kttui/Smart-Range-Hood-Closed-Loop-Control-and-Online-Upgrade-System/(list of files, cad)

Other CAD files:
基于STM32+FreeRTOS的智能油烟机闭环控制与在线升级系统V1/Objects/test_server_signature.obj
基于STM32+FreeRTOS的智能油烟机闭环控制与在线升级系统V1/Objects/boot_p256.obj
基于STM32+FreeRTOS的智能油烟机闭环控制与在线升级系统V1/Objects/test_p256.obj
