kttui/Smart-Range-Hood-Closed-Loop-Control-and-Online-Upgrade-System/基于STM32+FreeRTOS的智能油烟机闭环控制与在线升级系统V1/Application/control_task.c

#include "control_task.h"
#include "control_service.h"
#include "message_def.h"
#include "FreeRTOS.h"
#include "queue.h"

void control_task(void *pvParameters)
{
    SystemEvent_t event;

    (void)pvParameters;

    Control_Service_Init();

    while (1)
    {
        if (xQueueReceive(system_event_queue, &event, portMAX_DELAY) == pdTRUE)
        {
            Control_Service_ProcessEvent(&event);
        }
    }
}
