kttui/Smart-Range-Hood-Closed-Loop-Control-and-Online-Upgrade-System/基于STM32+FreeRTOS的智能油烟机闭环控制与在线升级系统V1/Driver/drv_encoder.h

#ifndef __DRV_ENCODER_H
#define __DRV_ENCODER_H

#include <stdint.h>

void Encoder_Init(void);
int16_t Encoder_GetDeltaAndReset(void);
int16_t Encoder_CalcRpm(int16_t delta_count, uint16_t sample_ms);

#endif
