kttui/Smart-Range-Hood-Closed-Loop-Control-and-Online-Upgrade-System/基于STM32+FreeRTOS的智能油烟机闭环控制与在线升级系统V1/Service/motor_control_service.h

#ifndef __MOTOR_CONTROL_SERVICE_H
#define __MOTOR_CONTROL_SERVICE_H

#include "stm32f10x.h"

#define MOTOR_CONTROL_SERVICE_PERIOD_MS      50

void Motor_Control_Service_Init(void);
void Motor_Control_Service_Process(void);

#endif /* __MOTOR_CONTROL_SERVICE_H */
