kttui/Smart-Range-Hood-Closed-Loop-Control-and-Online-Upgrade-System/基于STM32+FreeRTOS的智能油烟机闭环控制与在线升级系统V1/BSP/bsp_delay.c

#include "bsp_delay.h"
#include "bsp_sys.h"
////////////////////////////////////////////////////////////////////////////////// 	 
//如果需要使用OS,则包括下面的头文件即可.
#if SYSTEM_SUPPORT_OS
#include "FreeRTOS.h"					//FreeRTOS使用		  
#include "task.h" 
//extern led_d led1; /*used to debug*/
#endif
//////////////////////////////////////////////////////////////////////////////////	 
//本程序只供学习使用，未经作者许可，不得用于其它任何用途
//ALIENTEK STM32开发板
//使用SysTick的普通计数模式对延迟进行管理(支持OS)
//包括delay_us,delay_ms
//正点原子@ALIENTEK
//技术论坛:www.openedv.com
//创建日期:2016/11/28
//版本：V1.8
//版权所有，盗版必究。
//Copyright(C) 广州市星翼电子科技有限公司 2009-2019
//All rights reserved
//********************************************************************************
//修改说明
//////////////////////////////////////////////////////////////////////////////////  

static u8  fac_us=0;							//us延时倍乘数			   
static u16 fac_ms=0;							//ms延时倍乘数,在ucos下,代表每个节拍的ms数
 
 extern void xPortSysTickHandler(void);//OS的心跳函数声明--不甘心的咸鱼注

//systick中断服务函数,使用os时用到
void SysTick_Handler(void)
{	
    if(xTaskGetSchedulerState()!=taskSCHEDULER_NOT_STARTED)//系统已经运行
    {
		//led_off(&led1);//used to debug
        xPortSysTickHandler();	
    }
}

			   
//初始化延迟函数
//SYSTICK的时钟固定为AHB时钟，基础例程里面SYSTICK时钟频率为AHB/8
//这里为了兼容FreeRTOS，所以将SYSTICK的时钟频率改为AHB的频率！
//SYSCLK:系统时钟频率
void delay_init()
{
	uint32_t  reload;
	SysTick_CLKSourceConfig(SysTick_CLKSource_HCLK);//选择外部时钟  HCLK
	fac_us=SystemCoreClock/1000000;				//不论是否使用OS,fac_us都需要使用
	reload=SystemCoreClock/1000000;				//每秒钟的计数次数 单位为M  
	reload*=1000000/configTICK_RATE_HZ;			//根据configTICK_RATE_HZ设定溢出时间
												//reload为24位寄存器,最大值:16777216,在72M下,约合0.233s左右	
	fac_ms=1000/configTICK_RATE_HZ;				//代表OS可以延时的最少单位	   

	SysTick->CTRL|=SysTick_CTRL_TICKINT_Msk;   	//开启SYSTICK中断
	SysTick->LOAD=reload; 						//每1/configTICK_RATE_HZ秒中断一次	
	SysTick->CTRL|=SysTick_CTRL_ENABLE_Msk;   	//开启SYSTICK    
}								    


//延时nus
//nus:要延时的us数.	
//nus:0~204522252(最大值即2^32/fac_us@fac_us=168)	    								   
void delay_us(u32 nus)
{		
	u32 ticks;
	u32 told,tnow,tcnt=0;
	u32 reload=SysTick->LOAD;				//LOAD的值	    	 
	ticks=nus*fac_us; 						//需要的节拍数 
	told=SysTick->VAL;        				//刚进入时的计数器值
	while(1)
	{
		tnow=SysTick->VAL;	
		if(tnow!=told)
		{	    
			if(tnow<told)tcnt+=told-tnow;	//这里注意一下SYSTICK是一个递减的计数器就可以了.
			else tcnt+=reload-tnow+told;	    
			told=tnow;
			if(tcnt>=ticks)break;			//时间超过/等于要延迟的时间,则退出.
		}  
	};										    
}  
//延时nms
//nms:要延时的ms数
//nms:0~65535
void delay_ms(u32 nms)
{	
	if(xTaskGetSchedulerState()!=taskSCHEDULER_NOT_STARTED)//系统已经运行
	{		
		if(nms>=fac_ms)						//延时的时间大于OS的最少时间周期 
		{ 
   			vTaskDelay(nms/fac_ms);	 		//FreeRTOS延时
		}
		nms%=fac_ms;						//OS已经无法提供这么小的延时了,采用普通方式延时    
	}
	delay_us((u32)(nms*1000));				//普通方式延时
}

//延时nms,不会引起任务调度
//nms:要延时的ms数
void delay_xms(u32 nms)
{
	u32 i;
	for(i=0;i<nms;i++) delay_us(1000);
}
