kttui/Smart-Range-Hood-Closed-Loop-Control-and-Online-Upgrade-System/基于STM32+FreeRTOS的智能油烟机闭环控制与在线升级系统V1/Driver/drv_key.h

#ifndef __DRV_KEY_H
#define __DRV_KEY_H

#include <stdint.h>

typedef enum
{
    KEY_ID_NONE = 0,
    KEY_ID_MODE,
    KEY_ID_SPEED,
    KEY_ID_LIGHT,
    KEY_ID_UPGRADE
} KeyId_t;

typedef enum
{
    KEY_ACTION_NONE = 0,
    KEY_ACTION_SHORT,
    KEY_ACTION_LONG
} KeyAction_t;

typedef struct
{
    KeyId_t id;
    KeyAction_t action;
} KeyEvent_t;

void Key_Init(void);
uint8_t Key_Scan(KeyEvent_t *event);

#endif
