kttui/Smart-Range-Hood-Closed-Loop-Control-and-Online-Upgrade-System/基于STM32+FreeRTOS的智能油烟机闭环控制与在线升级系统V1/Service/anti_backflow_service.h

#ifndef __ANTI_BACKFLOW_SERVICE_H
#define __ANTI_BACKFLOW_SERVICE_H

#include "stm32f10x.h"

#define ANTI_BACKFLOW_SERVICE_PERIOD_MS      100

typedef enum
{
    BACKFLOW_IDLE = 0,
    BACKFLOW_MONITORING,
    BACKFLOW_ACTIVE,
    BACKFLOW_RECOVERY
} BackflowState_t;

void Anti_Backflow_Service_Init(void);
void Anti_Backflow_Service_Process(void);

#endif /* __ANTI_BACKFLOW_SERVICE_H */
