kttui/Smart-Range-Hood-Closed-Loop-Control-and-Online-Upgrade-System/基于STM32+FreeRTOS的智能油烟机闭环控制与在线升级系统V1/Service/speed_service.h

#ifndef __SPEED_SERVICE_H
#define __SPEED_SERVICE_H

#include "stm32f10x.h"

#define SPEED_SERVICE_PERIOD_MS      50

void Speed_Service_Init(void);
void Speed_Service_Process(void);

#endif /* __SPEED_SERVICE_H */
