kttui/Smart-Range-Hood-Closed-Loop-Control-and-Online-Upgrade-System/基于STM32+FreeRTOS的智能油烟机闭环控制与在线升级系统V1/Bootloader/boot_flash.h

#ifndef __BOOT_FLASH_H
#define __BOOT_FLASH_H

#include <stdint.h>

int BootFlash_EraseApplication(void);
int BootFlash_Write(uint32_t offset, const uint8_t *data, uint16_t length);
int BootFlash_Matches(uint32_t offset, const uint8_t *data, uint16_t length);
int BootFlash_VectorIsValid(void);

#endif /* __BOOT_FLASH_H */
