kttui/Smart-Range-Hood-Closed-Loop-Control-and-Online-Upgrade-System/基于STM32+FreeRTOS的智能油烟机闭环控制与在线升级系统V1/Bootloader/test_p256.c

#include "boot_p256.h"
#include <stdio.h>

static const unsigned char public_key[64] = {
    0x46,0x28,0xca,0xb0,0x78,0xf2,0x2d,0x11,0x56,0xed,0xe9,0x50,0xf4,0xf5,0x0d,0xb0,
    0xbe,0x49,0xd2,0x25,0xd3,0x68,0xcd,0xf5,0xaf,0x61,0x94,0x73,0x71,0x9d,0xe7,0xa3,
    0x47,0x9e,0x4d,0xaa,0x9f,0x87,0x3a,0xa7,0x7c,0x84,0xe3,0x90,0x5e,0x28,0x05,0x8e,
    0xd4,0x1d,0x48,0x34,0xcf,0xeb,0x4b,0x16,0x69,0x8c,0x08,0x4c,0x58,0xe1,0x2f,0xcf
};
static const unsigned char hash_value[32] = {
    0xc7,0x82,0x63,0x8c,0xe4,0xef,0xfe,0xf6,0x21,0x79,0x26,0xe4,0x2b,0xb5,0x31,0x42,
    0x13,0xd5,0xe2,0xe9,0xed,0xd4,0x40,0x71,0xf4,0x38,0xa3,0x3c,0x44,0x44,0xd1,0x08
};
static unsigned char signature[64] = {
    0xcd,0x72,0x6f,0x70,0x7e,0xd8,0x49,0x37,0x28,0x50,0x97,0x33,0x26,0x3b,0xb2,0x17,
    0x30,0x95,0x9d,0x88,0x35,0xcf,0xf8,0xe4,0x4b,0x75,0xf2,0x91,0xe5,0xb9,0xc2,0x06,
    0x84,0x8b,0xbf,0x99,0x9c,0xc4,0x8e,0x00,0x23,0xa0,0x01,0xfd,0x6d,0xe3,0xfd,0x86,
    0xc3,0xd5,0xd0,0x84,0xdb,0x49,0xe1,0xc8,0x4b,0x07,0xb4,0x15,0x41,0x14,0x71,0x11
};

/* Regression vector from the signed 1.1.0 OTA release. */
static const unsigned char release_hash[32] = {
    0x43,0xc0,0x39,0xc0,0xf3,0x40,0x3b,0x85,0x17,0x12,0x98,0x2b,0xfd,0xca,0xf6,0xe4,
    0xba,0x5d,0x9a,0x25,0xbf,0x72,0xaa,0x56,0xd4,0x07,0x8a,0xf0,0x8d,0x49,0x10,0x32
};
static const unsigned char release_signature[64] = {
    0x66,0x00,0x85,0xd2,0x81,0x49,0x36,0x01,0xd2,0x22,0x31,0x2c,0x5a,0xf8,0xe2,0x07,
    0x54,0x1d,0xb4,0x37,0x8e,0x1d,0x95,0x39,0x01,0x5b,0x23,0xe1,0xe9,0x8d,0xf3,0xb9,
    0xcd,0xbf,0x7d,0xa4,0xcc,0x21,0xfd,0xf2,0xbc,0x2b,0xbd,0xe0,0x0a,0xa6,0x61,0x5b,
    0xa0,0x44,0xe1,0x9f,0x02,0x82,0x8d,0x43,0x5f,0xe8,0x84,0xda,0x03,0xf1,0xf7,0x66
};

int main(void)
{
    if (!BootP256_Verify(public_key, hash_value, signature)) { return 1; }
    signature[0] ^= 1U;
    if (BootP256_Verify(public_key, hash_value, signature)) { return 2; }
    if (!BootP256_Verify(public_key, release_hash, release_signature)) { return 3; }
    puts("P-256 verification self-test passed");
    return 0;
}
